viso256/biomedicinska_elektronika_projekt/gsr_pcb/preview_files/gsr_pcb_front.png

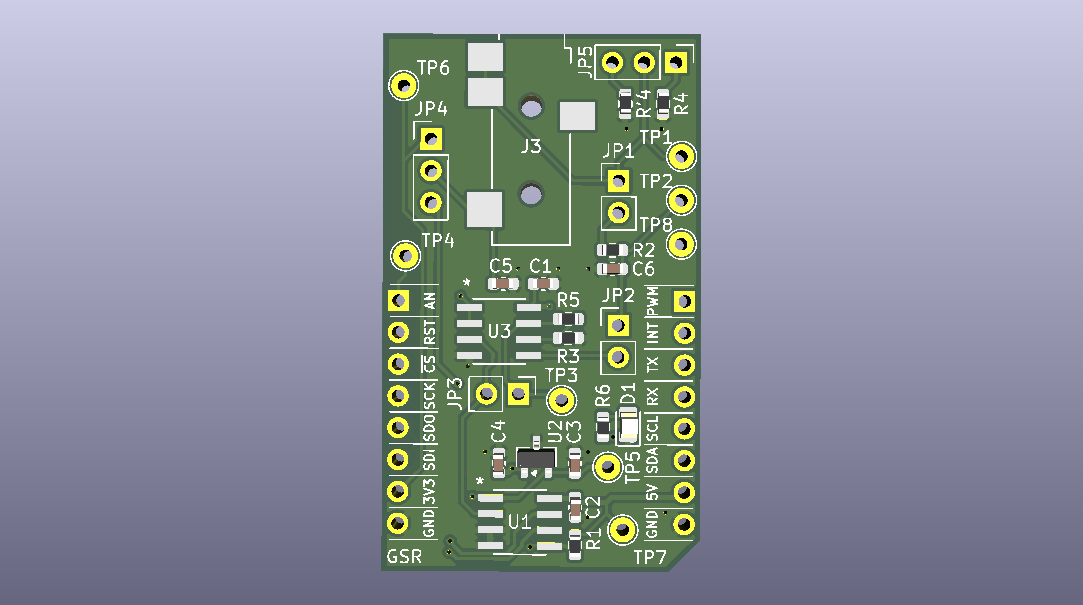
gsr_pcb/preview_files/gsr_pcb_front.png
