viso256/biomedicinska_elektronika_projekt/Poročilo.pdf

# Projekt EDA (GSR Click) – Bločni diagram in tabela napovedi

Neža Povh, Vid Sojer

## 1 Bločni diagram

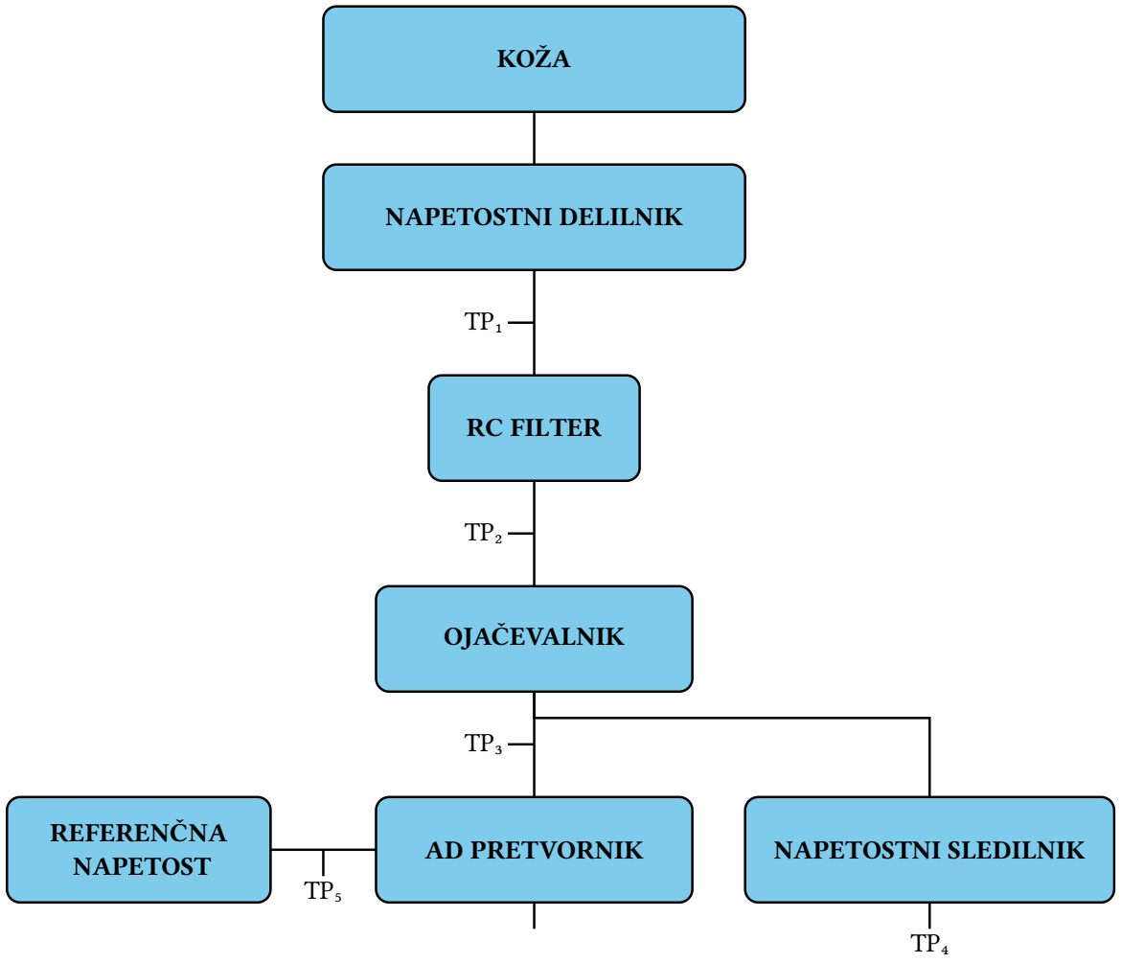
[picture p3: figure]
KOŽA; NAPETOSTNI DELILNIK; RC FILTER; OJAČEVALNIK; AD PRETVORNIK; NAPETOSTNI SLEDILNIK; REFERENČNA NAPETOST

## 2 Shema z označenimi testnimi točkami

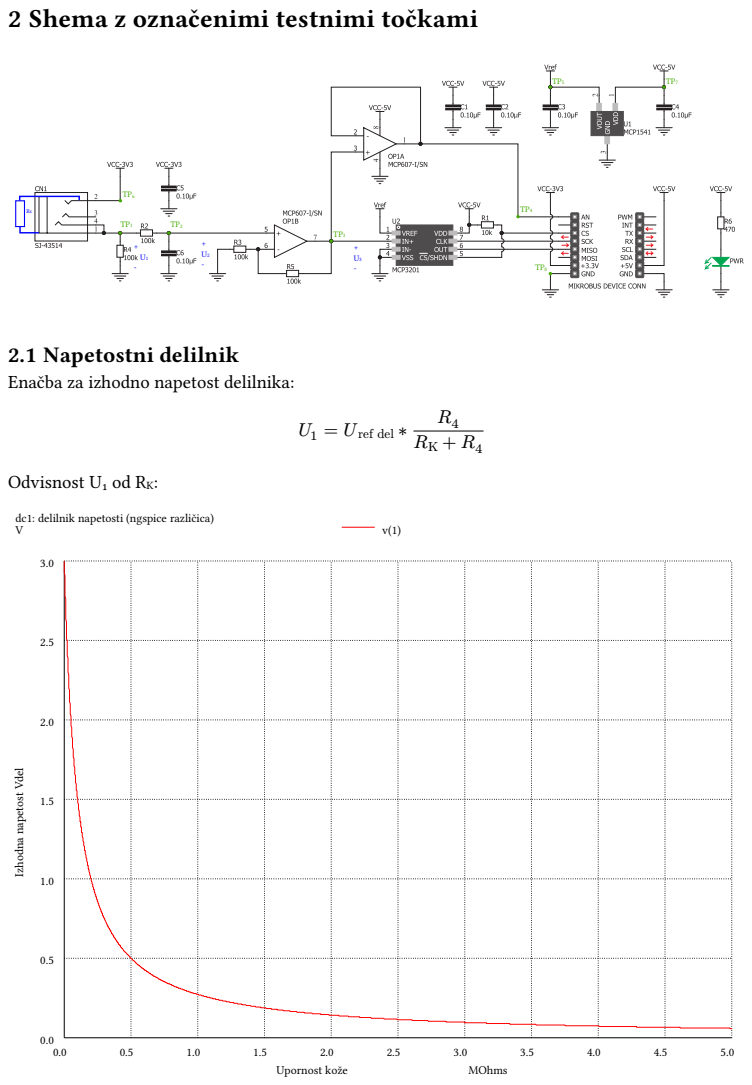
[picture p4: page 2]

2.1 Napetostni delilnik
Enačba za izhodno napetost delilnika:

dc1: delilnik napetosti (ngspice različica)

### 2.2 RC filter

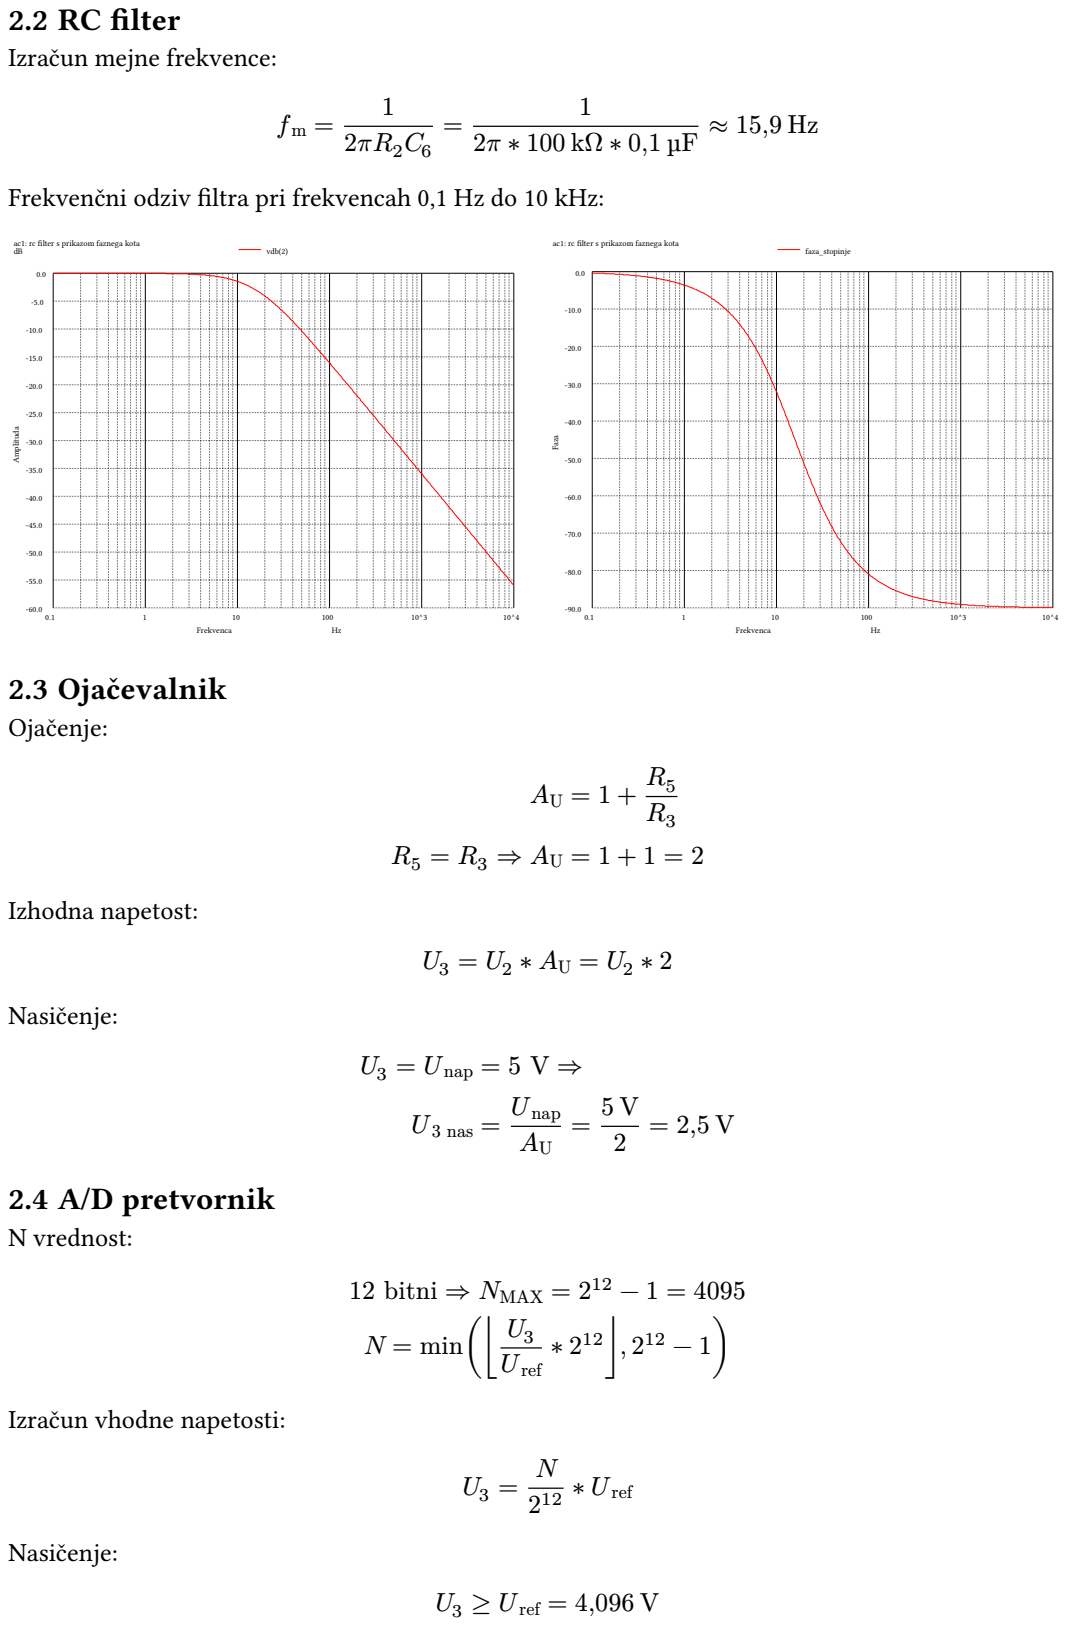
[picture p5: page 3]
Frekvenca; Amplituda; vdb(2); Faza; faza_stopinje; 2.3 Ojačevalnik; Ojačenje:; Izhodna napetost:; Nasičenje:; U3 = Unap = 5 V ⇒; U3 nas =; Unap AU; 2.4 A/D pretvornik; N vrednost:; 12 bitni ⇒ NMAX = 2; N = min(⌊; Uref; ∗ Uref; U3 ≥ Uref = 4,096 V

Izračun mejne frekvence:

Frekvenčni odziv filtra pri frekvencah 0,1 Hz do 10 kHz:

ac1: rc filter s prikazom faznega kota

Izračun vhodne napetosti:

### 2.5 Napetostni sledilnik

AU = 1
U AN = U3

### 2.6 Referenčna napetost

Referenčna napetost, definirana v podatkovnem listu:

Uref = 4,096 V

## 3 Meje nasičenja

- Zgornja meja A/D pretvornika:

4095 (U3 = 4, 096 V)

U2 =

U3
2

= 2, 048 V = U1

U1 = UCC

R4
RK + R4
U1

(RK + R4

) = UCCR4

RK =

UCCR4
U1

− R4 = R4(

UCC
U1

− 1)

GS =

1
RK

= 1, 4 µS → N = 4095

- MCP607

USS − 0, 3 V ≤ UIN ≤ UDD − 1, 1 V −0, 3 V ≤ U3 ≤ 3, 9 V

U1 = U2 =

U3
2

→ U1 ≤ 1, 95 V

RS = 69, 2 kΩ
G = 14, 4 µS (manj od A/D)
- Spodnja meja A/D pretvornika:

N = 1

N = 4096

u3

Uref

→ U3 =

N ∗ Uref
4096

= 1 mV

U1 = 0, 5 mV
RS = R4(

UCC
U1

− 1)

G = 1, 5 nS

## 4 Ločljivost

N = x

R4G
1 + R4G
N(1 + R4G) = xR4G
N + NR4G = xR4G
NR4G − xR4G = −N
G(NR4 − xR4

) = −N

G =

N
R4

(x − N)

dG
dN

=

R4

(x − N) − N(−R4

)
(R4

(x − N))

2

=

R4x − NR4 + NR4
R²
4

(x − N)

2

=

x
R4

(x − N)

2

nizek G (N → 0) :

dG
dN

= 1,2 nS

visok G (N = 4095) :

dG
dN

= 0,0105 nS

## 5 Največji tok skozi kožo

I =

U CC
RK + R4

RK → 0 ⇒ I <

U CC
R4

= 33 µA

RK | I
0 kΩ | 33,0 μA
100 kΩ | 16,5 μA
1000 kΩ | 3,0 μA
∞ | 0

## 6 Tabela napovedanih vrednosti

GK | RK | TP1 | TP2 | TP3 | TP4 | TP5 | TP6 | TP7 | TP8 | NADC
0,00 μS | ∞ | 0,000 V | 0,000 V | 0,000 V | 0,000 V | 4,096 V | 3,3 V | 5,0 V | 0 V | 0
21,27 μS | 47 kΩ | 2,245 V | 2,245 V | 4,490 V | > 3,9 V | 4,096 V | 3,3 V | 5,0 V | 0 V | 4095
14,70 μS | 68 kΩ | 1,964 V | 1,964 V | 3,929 V | > 3,9 V | 4,096 V | 3,3 V | 5,0 V | 0 V | 3928
10,00 μS | 100 kΩ | 1,650 V | 1,650 V | 3,300 V | 3,300 V | 4,096 V | 3,3 V | 5,0 V | 0 V | 3300
4,54 μS | 220 kΩ | 1,031 V | 1,031 V | 2,063 V | 2,063 V | 4,096 V | 3,3 V | 5,0 V | 0 V | 2062
2,12 μS | 470 kΩ | 0,579 V | 0,579 V | 1,158 V | 1,158 V | 4,096 V | 3,3 V | 5,0 V | 0 V | 1157
1,00 μS | 1000 kΩ | 0,300 V | 0,300 V | 0,600 V | 0,600 V | 4,096 V | 3,3 V | 5,0 V | 0 V | 600
0,45 μS | 2200 kΩ | 0,143 V | 0,143 V | 0,287 V | 0,287 V | 4,096 V | 3,3 V | 5,0 V | 0 V | 286
0,21 μS | 4700 kΩ | 0,069 V | 0,069 V | 0,137 V | 0,137 V | 4,096 V | 3,3 V | 5,0 V | 0 V | 137
