viso256/biomedicinska_elektronika_projekt/gsr_pcb/preview_files/IMG_20261110_165734.jpg

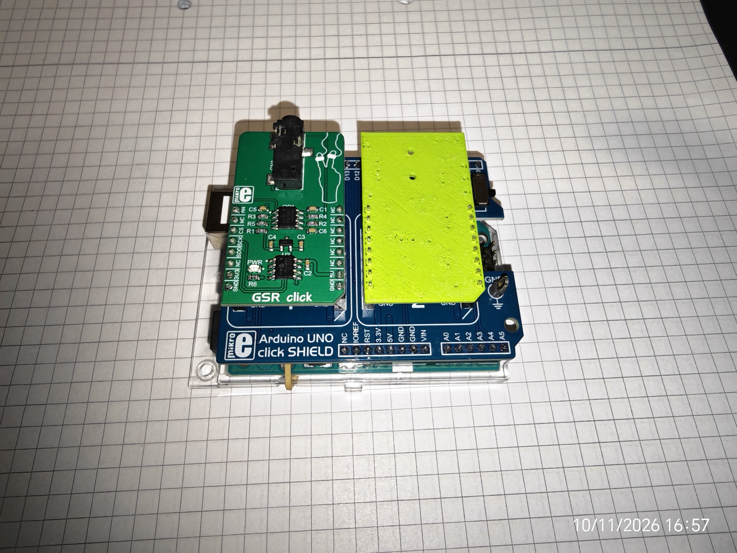
gsr_pcb/preview_files/IMG_20261110_165734.jpg
