viso256/biomedicinska_elektronika_projekt/gsr_pcb/production/bom.csv

Designator | Footprint | Quantity | Value | LCSC Part #
C1, C2, C4, C5, C6 | 0603 | 5 | 0.10uF | C14663
C3 | 0603 | 1 | 1uF | C15849
D1 | 0805 | 1 | PWR | C2297
J3 | SJ-43514-SMT_CUD | 1 | SJ-43514-SMT-TR | C4992301
R'4 | 0603 | 1 | 47k | C25819
R1 | 0603 | 1 | 10k | C25804
R2, R3, R4, R5 | 0603 | 4 | 100k | C25803
R6 | 0603 | 1 | 470 | C23179
U1 | SOIC8-N_MC_MCH | 1 | MCP3201 | C49274
U2 | SOT-23 | 1 | MCP1541-TT | C7375
U3 | SOIC8-N_MC_MCH | 1 | Opamp_Dual | C16279
