viso256/biomedicinska_elektronika_projekt/dokumentacija/gsr-click-schematic-v100.pdf

# GSR click schematic v100

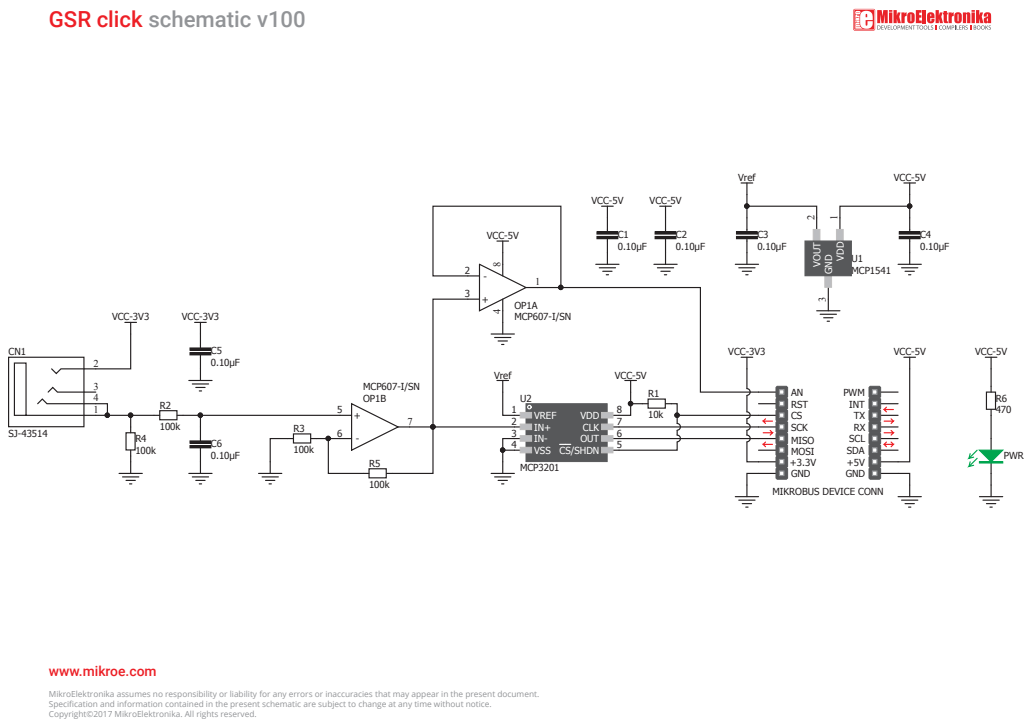
[picture p7: page 1]

MikroElektronika assumes no responsibility or liability for any errors or inaccuracies that may appear in the present document.
Specification and information contained in the present schematic are subject to change at any time without notice.
Copyright©2017 MikroElektronika. All rights reserved.
