viso256/biomedicinska_elektronika_projekt/gsr_pcb/preview_files/gsr_pcb_schematic.pdf

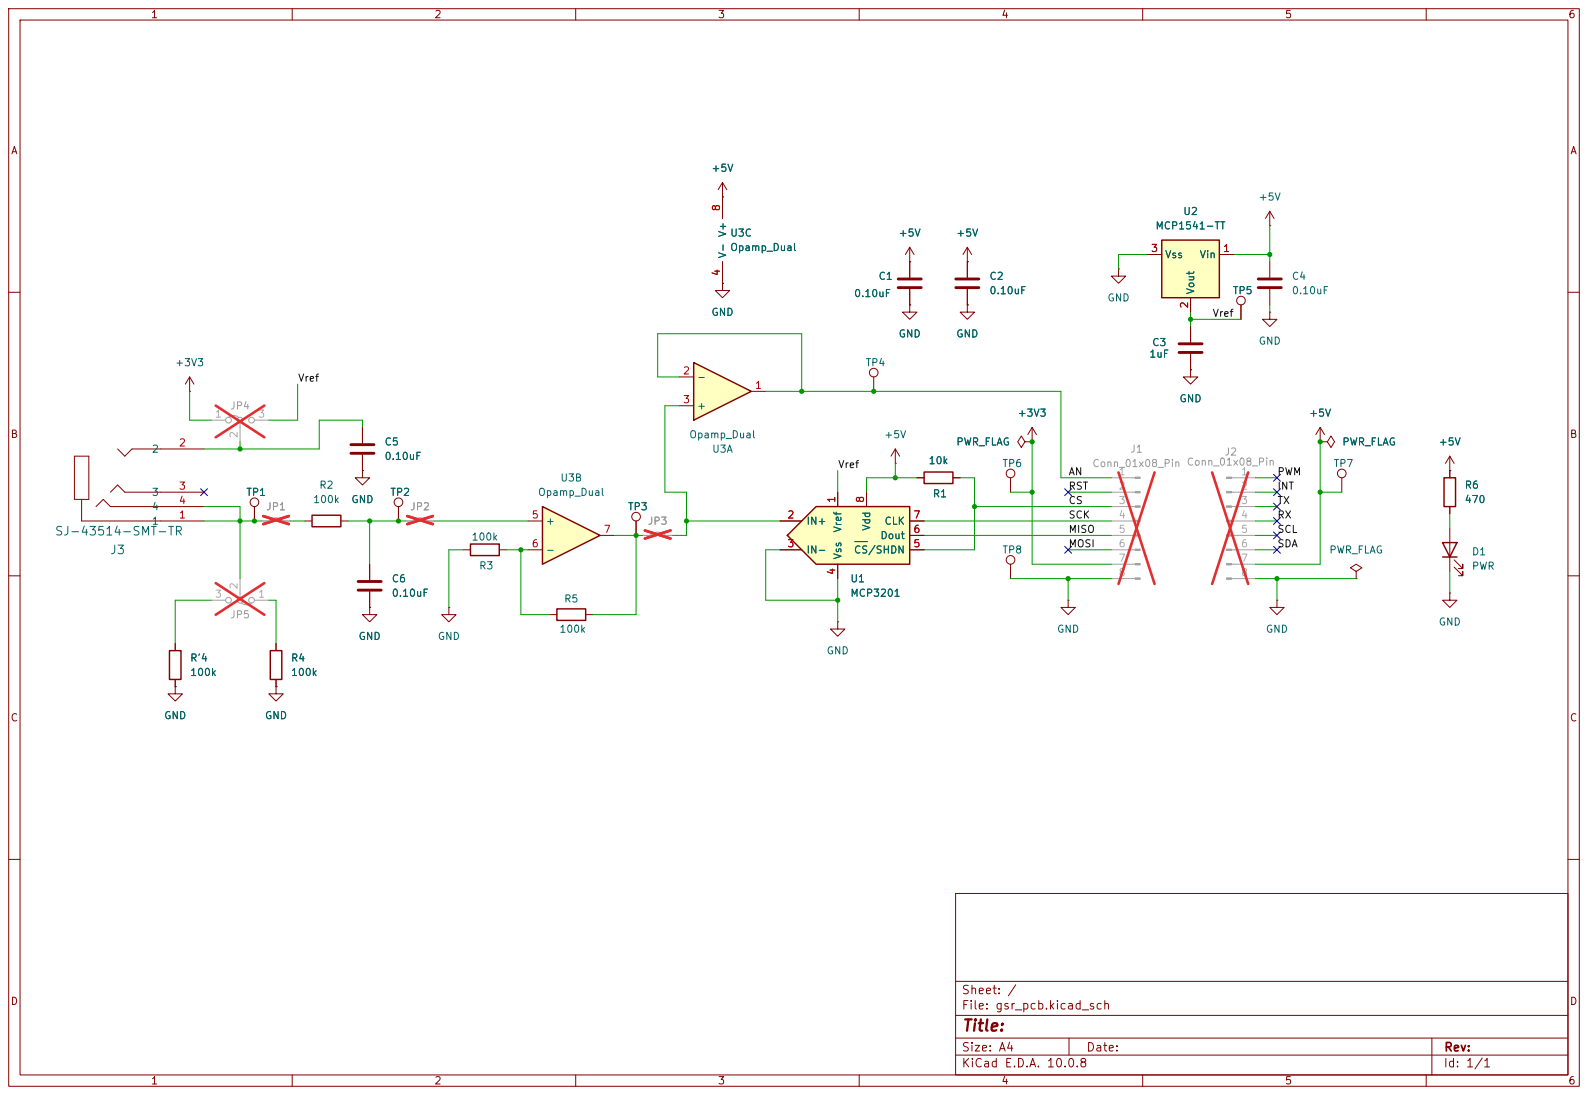
[picture p8: page 1]

Size: A4 | Rev:
KiCad E.D.A. 10.0.8 | Id: 1/1
