viso256/biomedicinska_elektronika_projekt/gsr_pcb/preview_files/gsr_pcb.pdf

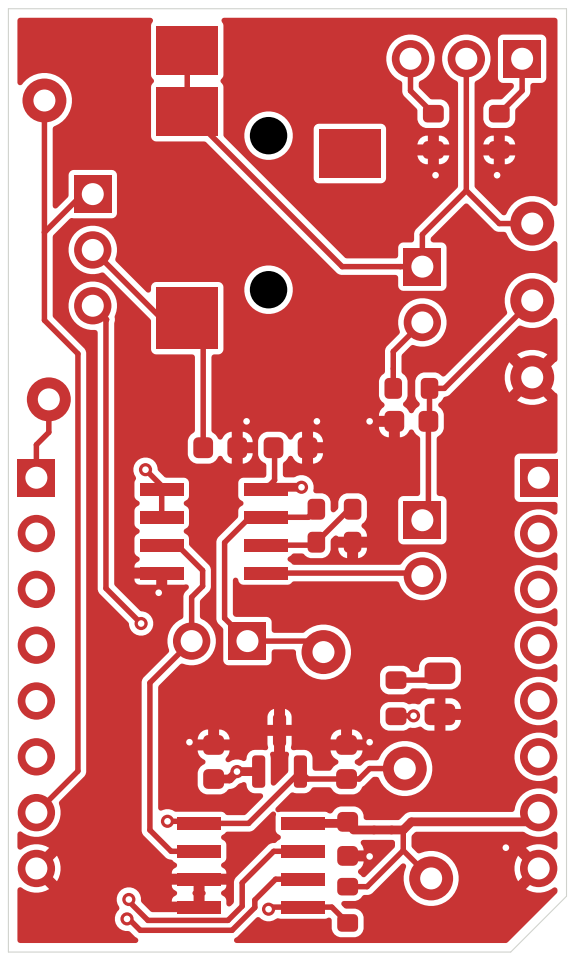
[picture p9: page 1]

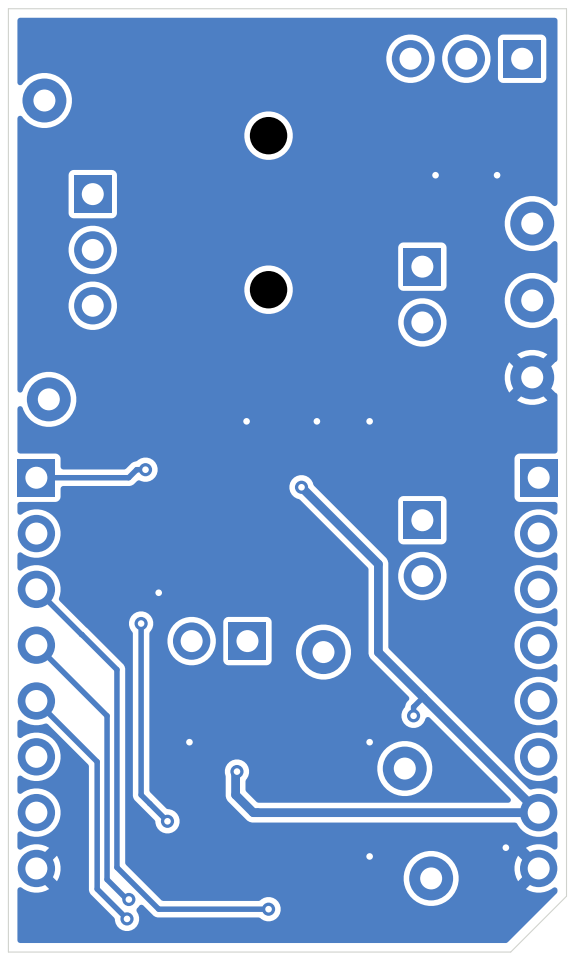
[picture p10: page 2]

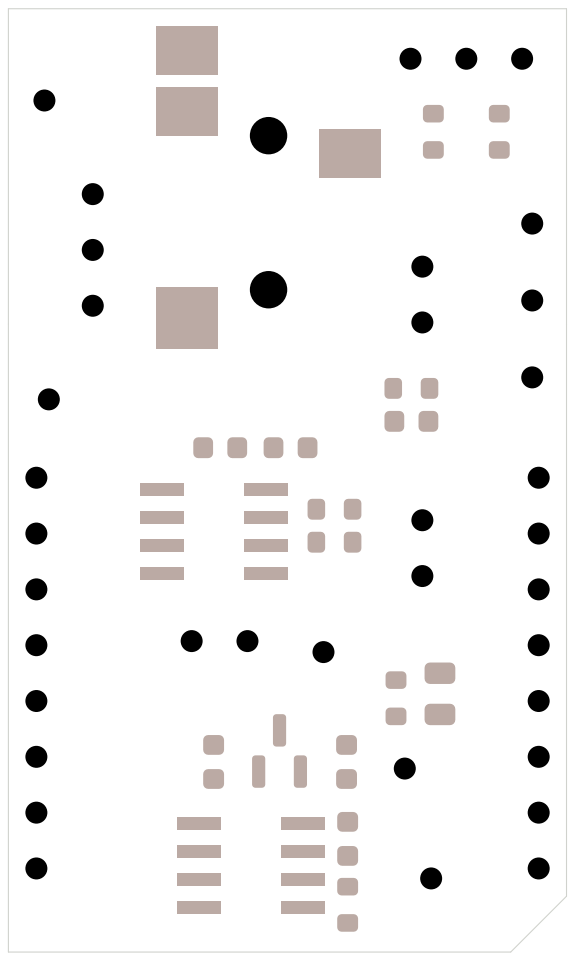
[picture p11: page 3]

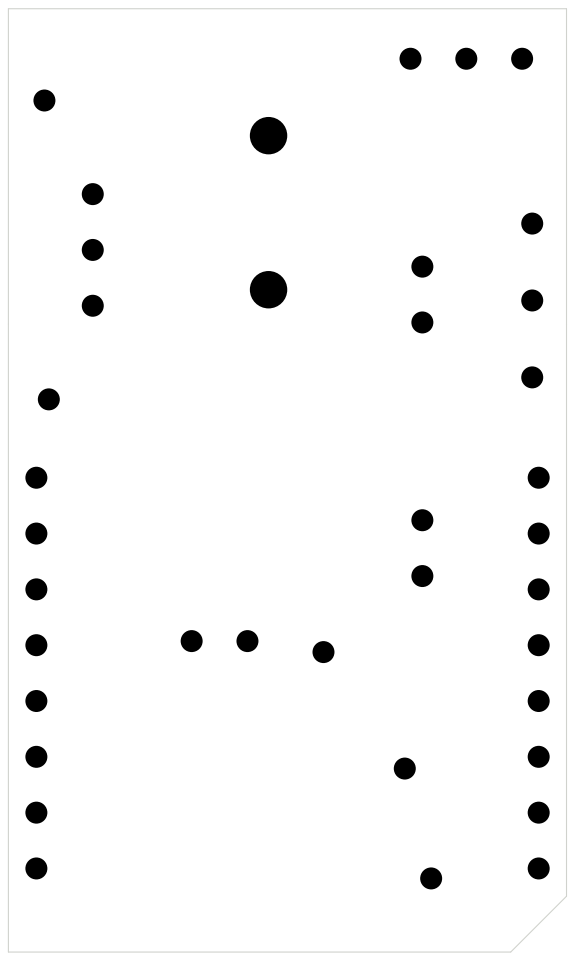
[picture p12: page 4]

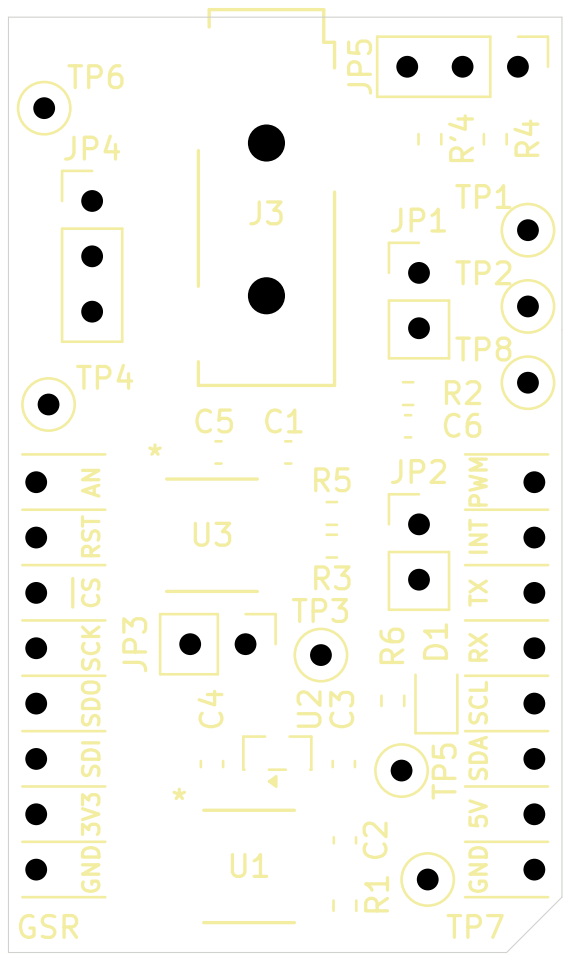
[picture p13: page 5]

AN RST CS SCK SDO SDI 3V3 GND PWM INT TX RX SCL SDA 5V GND GSR C4 JP3 R3 C2 R2

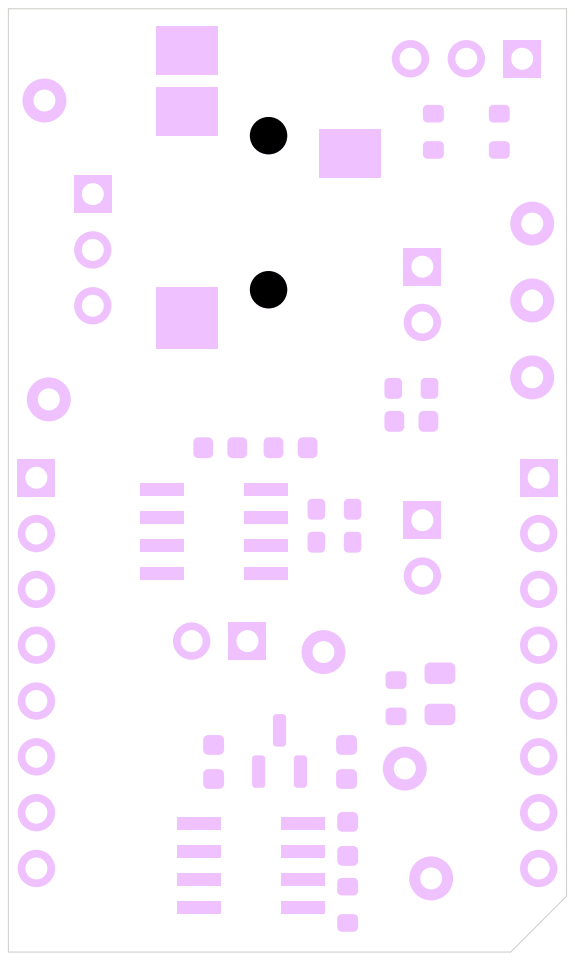
[picture p14: page 7]

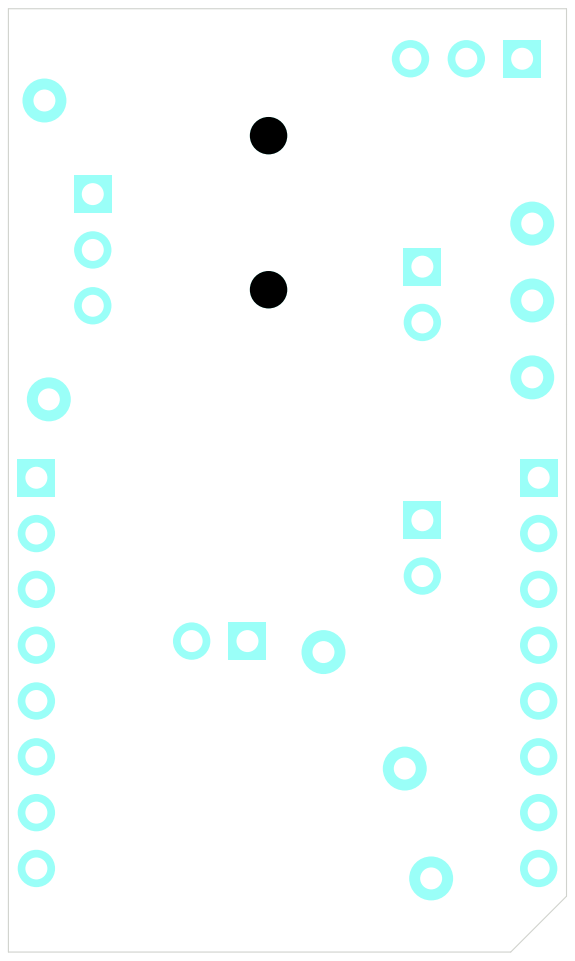
[picture p15: page 8]
