viso256/biomedicinska_elektronika_projekt/gsr_pcb/gsr_pcb.kicad_pcb

## KiCad design gsr_pcb/gsr_pcb.kicad_pcb (2026-11-13)

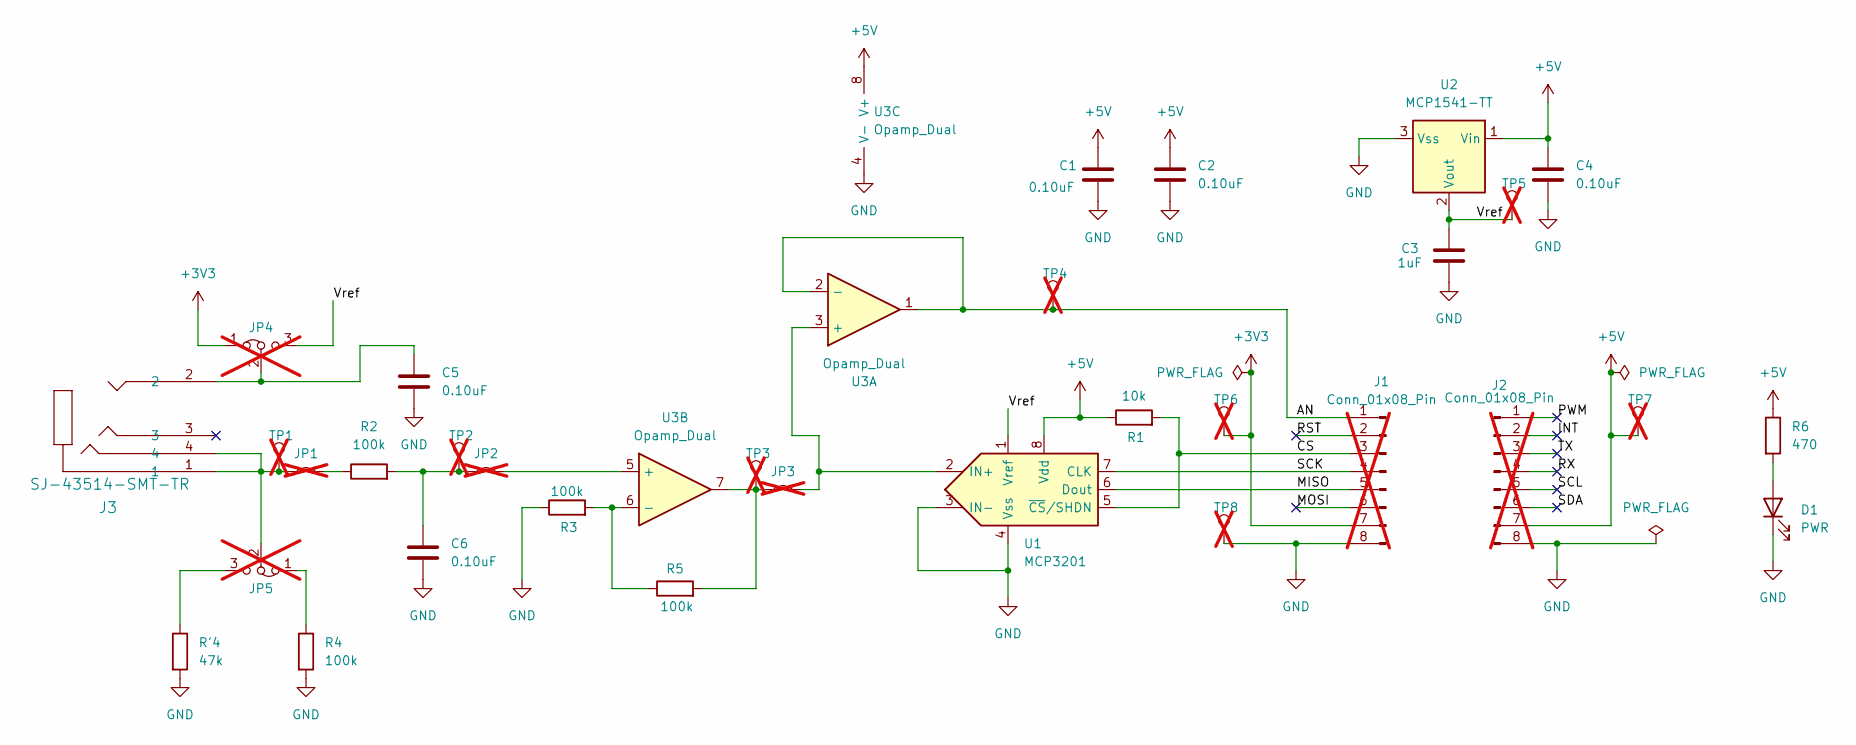
[picture p16: schematic gsr_pcb.kicad_sch]

Parts:
C1, C2, C4, C5, C6: 0.10uF; C_0603_1608Metric; LCSC C14663
C3: 1uF; C_0603_1608Metric; LCSC C15849
D1: PWR; LED_0805_2012Metric; LCSC C2297
J1, J2: Conn_01x08_Pin; PinHeader_1x08_P2.54mm_Vertical; not fitted
J3: SJ-43514-SMT-TR; SJ-43514-SMT_CUD; LCSC C4992301
JP1, JP2, JP3: Jumper_2_Small_Bridged; PinHeader_1x02_P2.54mm_Vertical; not fitted
JP4, JP5: Jumper_3_Bridged12; PinHeader_1x03_P2.54mm_Vertical; not fitted
R1: 10k; R_0603_1608Metric; LCSC C25804
R2, R3, R4, R5: 100k; R_0603_1608Metric; LCSC C25803
R6: 470; R_0603_1608Metric; LCSC C23179
R'4: 47k; R_0603_1608Metric; LCSC C25819
TP1, TP2, TP3, TP4, TP5, TP6, TP7, TP8: TestPoint; TestPoint_THTPad_D2.0mm_Drill1.0mm; not fitted
U1: MCP3201; SOIC8-N_MC_MCH; LCSC C49274
U2: MCP1541-TT; SOT-23; LCSC C7375
U3: Opamp_Dual; SOIC8-N_MC_MCH; LCSC C16279

Connections:
+3V3: J1.7, JP4.1 (A), TP6.1 (1_1)
+5V: C1.1, C2.1, C4.1, J2.7, R1.1, R6.1, TP7.1 (1_1), U1.8 (Vdd), U2.1 (Vin), U3.8 (V+)
/AN: J1.1, TP4.1 (1_1), U3.1, U3.2 (-)
/CS: J1.3, R1.2, U1.5 (~CS/SHDN)
/INT: J2.2
/MISO: J1.5, U1.6 (Dout)
/MOSI: J1.6
/PWM: J2.1
/RST: J1.2
/RX: J2.4
/SCK: J1.4, U1.7 (CLK)
/SCL: J2.5
/SDA: J2.6
/TX: J2.3
/Vref: C3.1, JP4.3 (B), TP5.1 (1_1), U1.1 (Vref), U2.2 (Vout)
GND: C1.2, C2.2, C3.2, C4.2, C5.2, C6.2, D1.1 (K), J1.8, J2.8, R3.1, R4.2, R'4.2, TP8.1 (1_1), U1.3 (IN-), U1.4 (Vss), U2.3 (Vss), U3.4 (V-)
unnamed: D1.2 (A), R6.2
unnamed: J3.1, J3.4, JP1.1 (A), JP5.2 (C), TP1.1 (1_1)
unnamed: JP1.2 (B), R2.1
unnamed: C6.1, JP2.1 (A), R2.2, TP2.1 (1_1)
unnamed: JP2.2 (B), U3.5 (+)
unnamed: JP3.1 (A), R5.2, TP3.1 (1_1), U3.7
unnamed: JP3.2 (B), U1.2 (IN+), U3.3 (+)
unnamed: C5.1, J3.2, JP4.2 (C)
unnamed: JP5.1 (A), R4.1
unnamed: JP5.3 (B), R'4.1
unnamed: R3.2, R5.1, U3.6 (-)

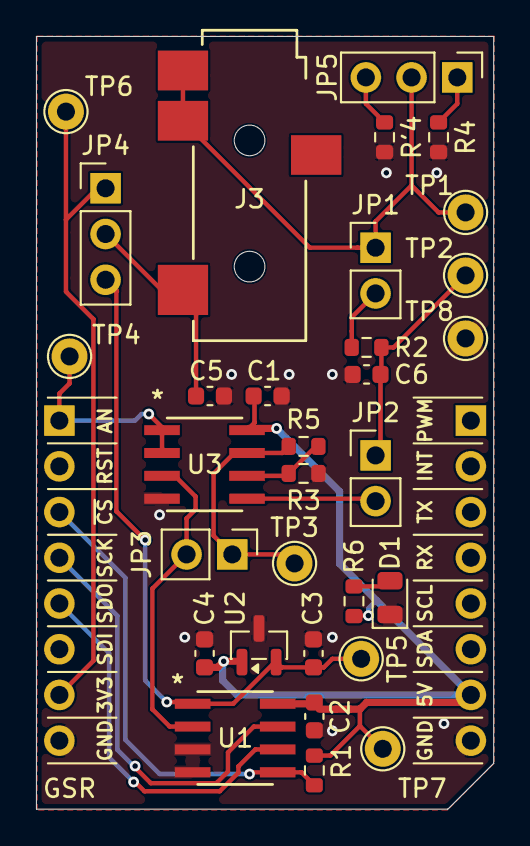
[picture p17: board gsr_pcb.kicad_pcb from above]

Board: 2 copper layers, 25.4 x 42.9 mm, 33 parts (0 on the bottom side), 19 nets.
