viso256/biomedicinska_elektronika_projekt/(commit log)

2026-10-26 Osnutek kalkulacije iz ADC
2026-10-26 Fixed divider voltage calculation
2026-10-29 Arduino sketch
2026-11-05 PCB schematic clone
2026-11-05 Linked footprints.
2026-11-09 Pcb layout.
2026-11-13 Fixed 3.5mm connector position
